harka069/GPS-receiver/README.md

# GPS-receiver (work in progress)
Multi-channel GPS receiver for L1 carrier with dedicated high-frequency frontend, processing within DSP routines and user interface on a personal computer.

## Development tools (start here)
To begin designing our own GPS receiver, we must first create proper tools for designing microcontrollers, FPGA circuits, and programmers. We need to build the following:
- [FPGA programmer](development%20tools/FPGA/FPGA%20programmer)
- [FPGA development board](development%20tools/FPGA/FPGA%20demo%20board)
- [MCU development board](development%20tools/MCU)
