harka069/GPS-receiver/development tools/FPGA/FPGA demo board/iCE40LP384_demo_project/iCE40LP384_blink/iCE40LP384_blink_Implmnt/synlog/report/iCE40LP384_blink_compiler_errors.txt

@E: CS164 :"C:\Users\Aljaz\OneDrive - Univerza v Ljubljani\PROJEKTI\GPS sprejemnik\FPGA\iCE40LP384-SG32\iCE40LP384_demo_project\main.v":28:30:28:33|Expecting wire for output connection, found LED2
