harka069/GPS-receiver/development tools/FPGA/FPGA demo board/iCE40LP384_demo_project/iCE40LP384_blink/iCE40LP384_blink_Implmnt/synlog/report/iCE40LP384_blink_compiler_warnings.txt

@W: CG921 :"C:\Users\Aljaz\OneDrive - Univerza v Ljubljani\PROJEKTI\GPS sprejemnik\FPGA\iCE40LP384-SG32\iCE40LP384_demo_project\main.v":12:5:12:8|LED1 is already declared in this scope.
