harka069/GPS-receiver/development tools/FPGA/FPGA demo board/iCE40LP384_demo_project/iCE40LP384_blink/iCE40LP384_blink_Implmnt/syntmp/statusReport.html

Project Settings
Project Name | iCE40LP384_blink_syn | Implementation Name | iCE40LP384_blink_Implmnt
Top Module | [auto] | Pipelining | 1
Retiming | 0 | Resource Sharing | 1
Fanout Guide | 10000 | Disable I/O Insertion | 0
Disable Sequential Optimizations | 0 | Clock Conversion | 1

Run Status
Job Name | Status | | | | CPU Time | Real Time | Memory | Date/Time
(compiler) | Complete | 6 | 0 | 0 | - | 00m:01s | - | 27/11/2023 20:20:13
(premap) | Complete | 3 | 1 | 0 | 0m:00s | 0m:00s | 133MB | 27/11/2023 20:20:15
(fpga_mapper) | Complete | 10 | 2 | 0 | 0m:00s | 0m:01s | 134MB | 27/11/2023 20:20:16
Multi-srs Generator | Complete | | | | | | | 27/11/2023 20:20:14

Area Summary
PADS | 5 | FLOPS | 25
RAMS (v_ram) | 0 | CARRYS | 24
LUTS (total_luts) | 25

Timing Summary
Clock Name | Req Freq | Est Freq | Slack
main|clk | 129.0 MHz | 109.6 MHz | -1.368

Optimizations Summary
Combined Clock Conversion | 1 / 0
