harka069/GPS-receiver/development tools/MCU/schematic_MCU_board_STM32G441.pdf

1 | 2 | 3 | 4 | 5 | 6 | 7 | 8

A

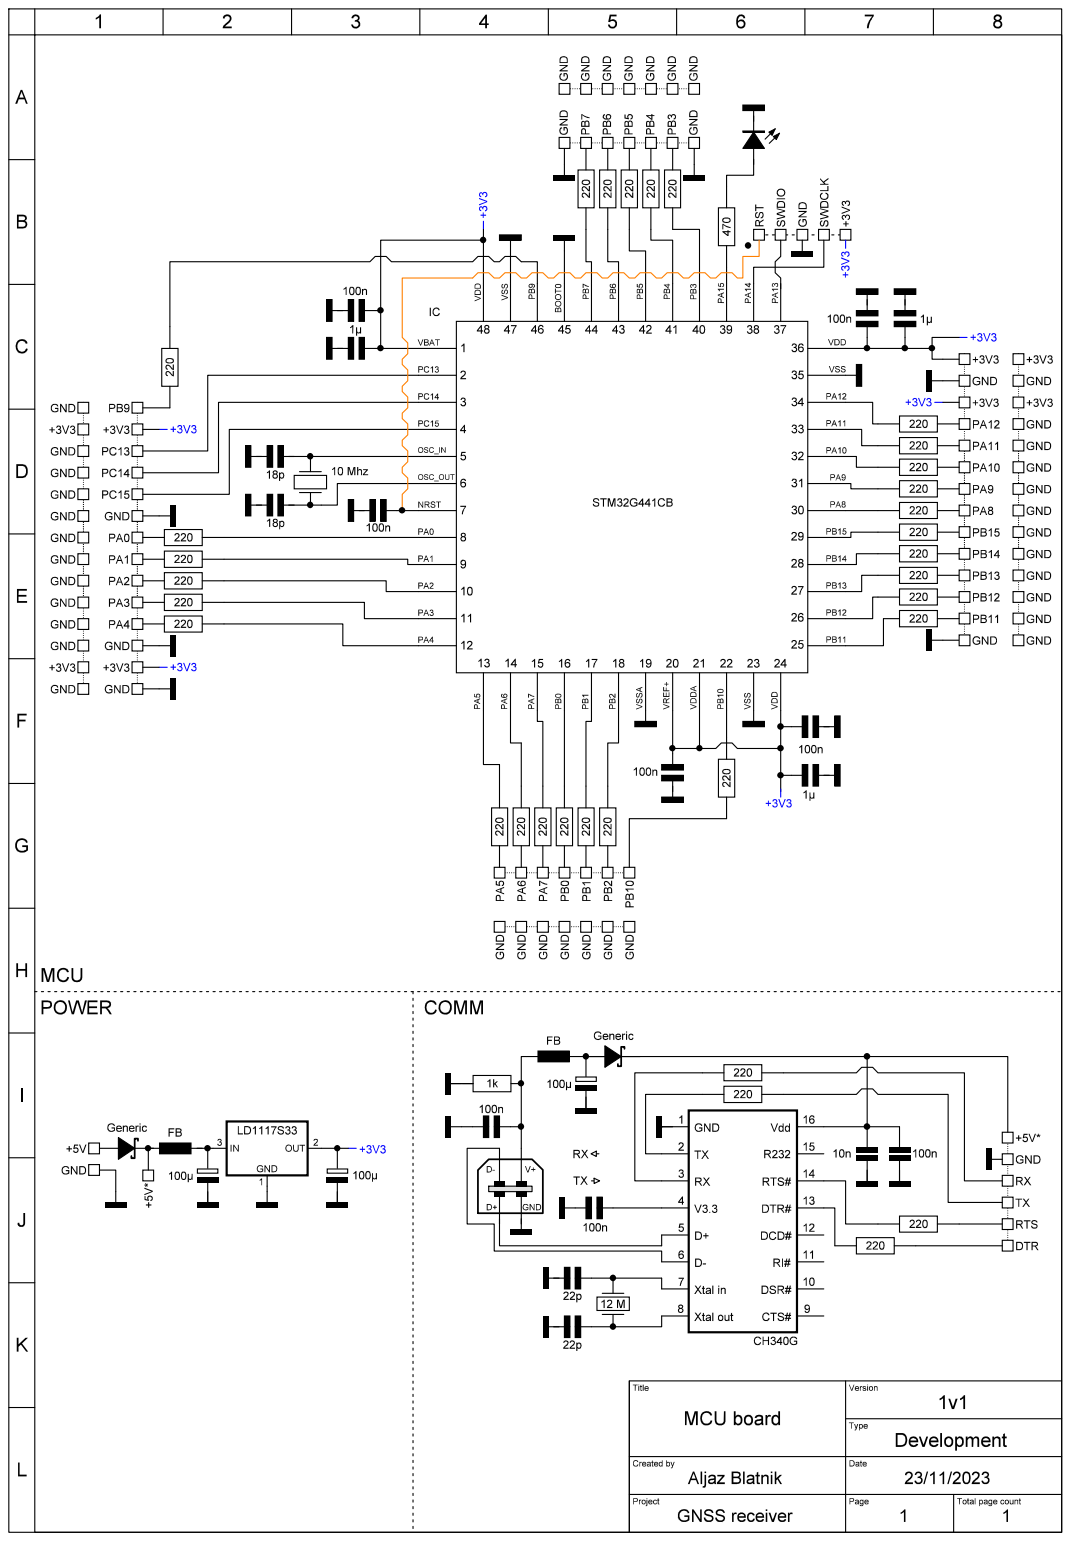
[picture p9: page 1]
