harka069/GPS-receiver/development tools/FPGA/FPGA demo board/schematic_iCE40LP384_demo_board.pdf

1 | 2 | 3 | 4 | 5 | 6 | 7 | 8 | 9 | 10 | 11 | 12

A

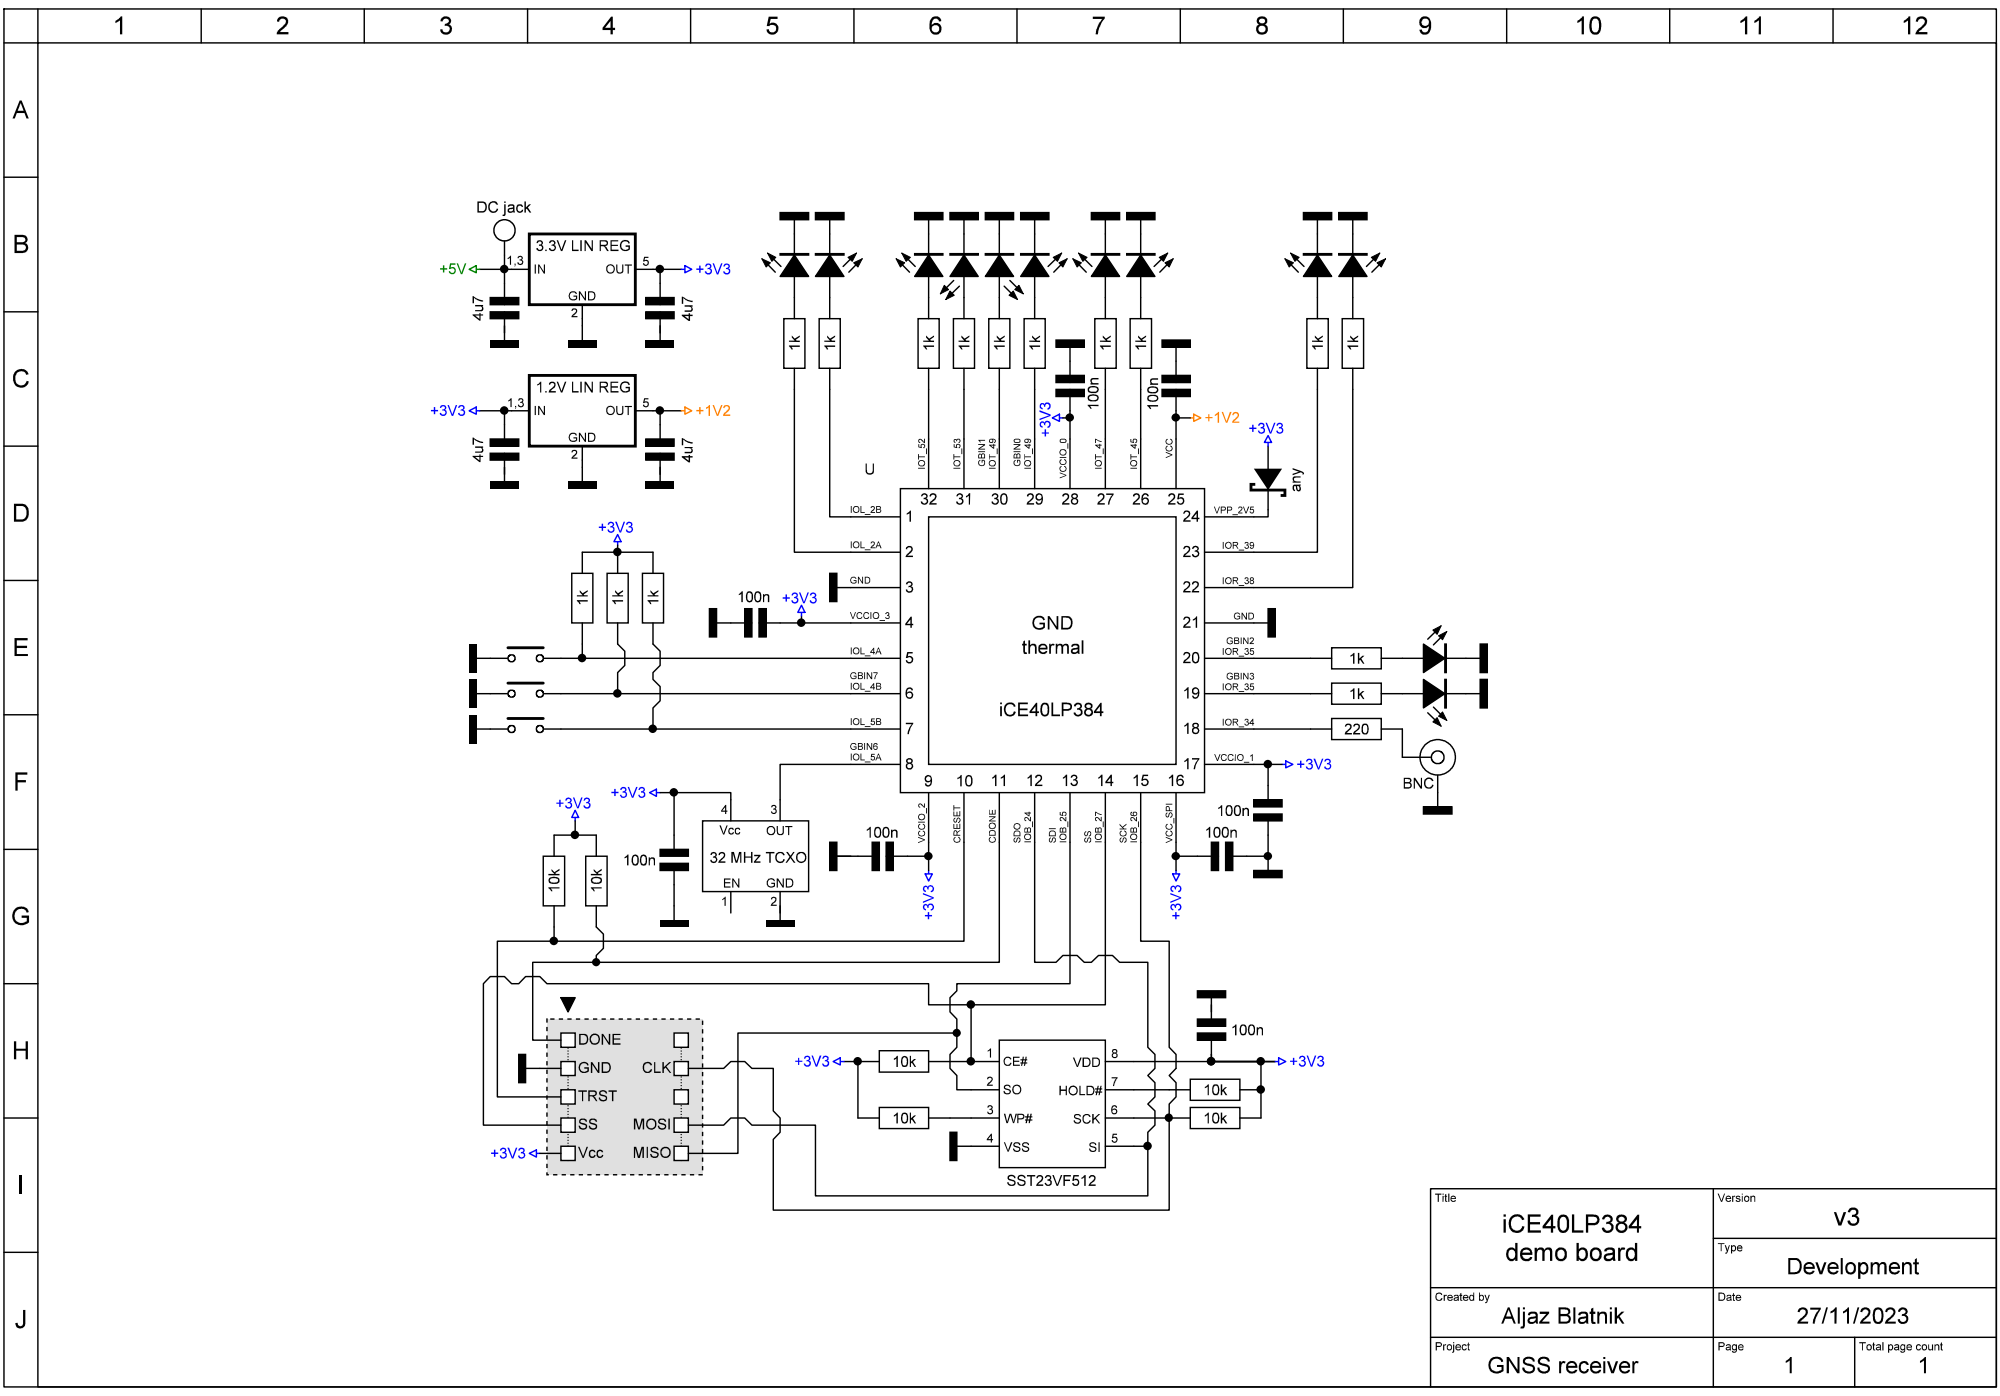
[picture p10: page 1]
