harka069/GPS-receiver/development tools/FPGA/FPGA programmer/schematic_Lattice_LSO_programmer.pdf

1 | 2 | 3 | 4 | 5 | 6 | 7 | 8 | 9 | 10 | 11 | 12

A

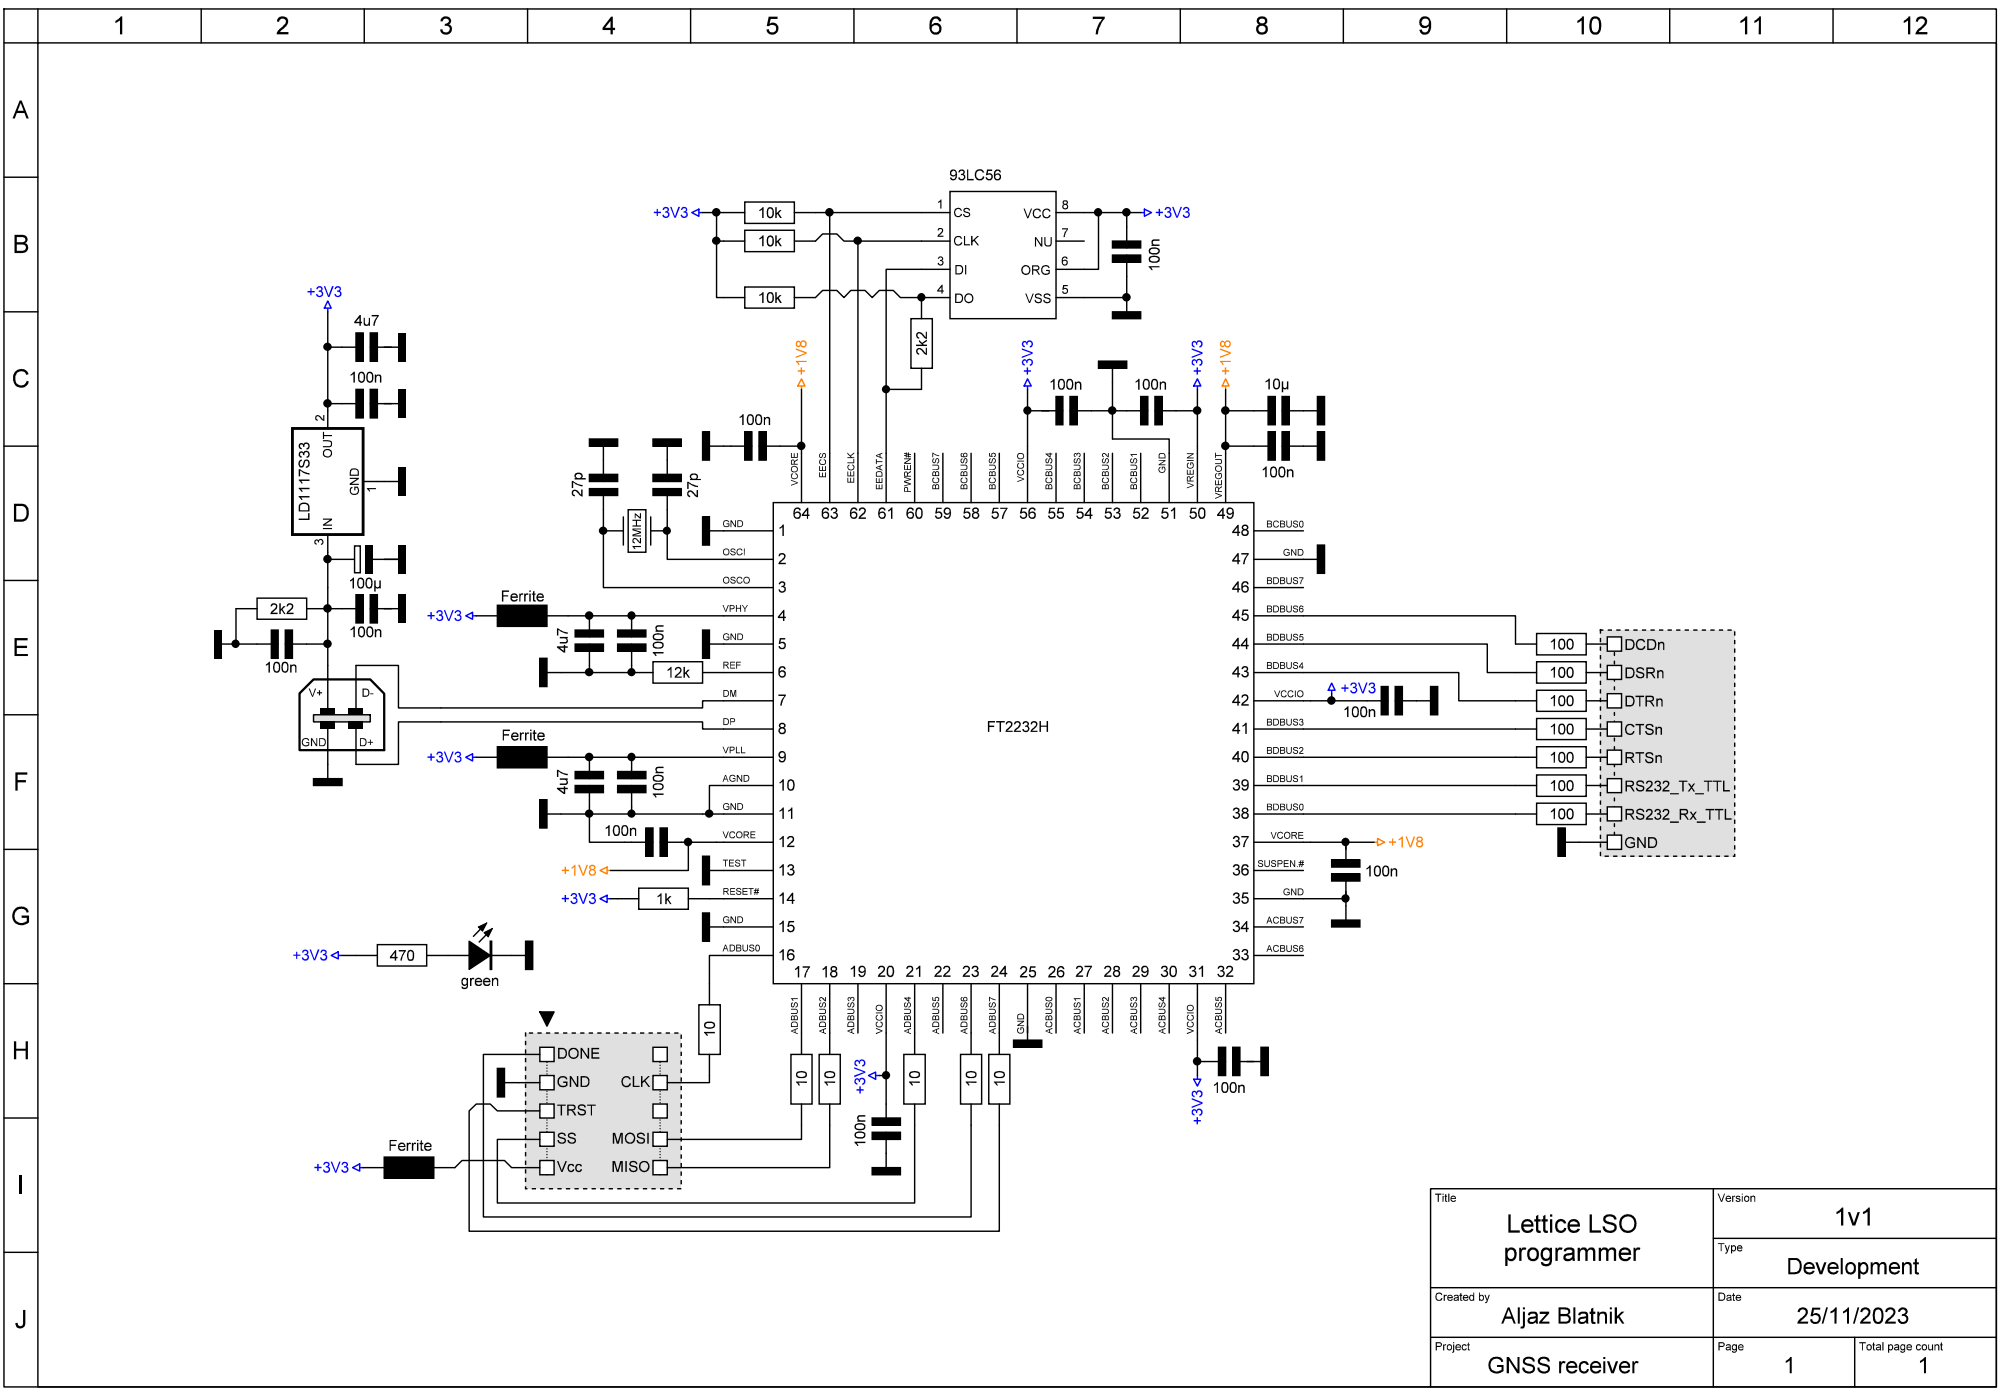
[picture p11: page 1]
