harka069/GPS-receiver/(list of files, drawings)

Other design files:
development tools/FPGA/FPGA demo board/iCE40LP384-SG32_demo_board.lay6
development tools/FPGA/FPGA demo board/iCE40LP384_demo_board.spl8
development tools/FPGA/FPGA programmer/Lattice_LSO_programmer.lay6
development tools/MCU/MCU_board_STM32G441.lay6
development tools/MCU/MCU_board_STM32G441.spl8
