harka069/GPS-receiver/development tools/FPGA/FPGA demo board/iCE40LP384_demo_project/iCE40LP384_blink/iCE40LP384_blink_Implmnt/sbt/outputs/simulation_netlist/main_sbt.v

// ******************************************************************************

// iCEcube Netlister

// Version:            2020.12.27943

// Build Date:         Dec  9 2020 18:18:12

// File Generated:     Nov 27 2023 20:23:32

// Purpose:            Post-Route Verilog/VHDL netlist for timing simulation

// Copyright (C) 2006-2010 by Lattice Semiconductor Corp. All rights reserved.

// ******************************************************************************

// Verilog file for cell "main" view "INTERFACE"

module main (
    LED2,
    BTN1,
    clk,
    LED3,
    LED1);

    output LED2;
    input BTN1;
    input clk;
    output LED3;
    output LED1;

    wire N__804;
    wire N__803;
    wire N__802;
    wire N__793;
    wire N__792;
    wire N__791;
    wire N__784;
    wire N__783;
    wire N__782;
    wire N__775;
    wire N__774;
    wire N__773;
    wire N__766;
    wire N__765;
    wire N__764;
    wire N__747;
    wire N__744;
    wire N__741;
    wire N__738;
    wire N__735;
    wire N__732;
    wire N__729;
    wire N__726;
    wire N__723;
    wire N__720;
    wire N__717;
    wire N__714;
    wire N__711;
    wire N__708;
    wire N__705;
    wire N__702;
    wire N__699;
    wire N__696;
    wire N__693;
    wire N__690;
    wire N__687;
    wire N__684;
    wire N__681;
    wire N__678;
    wire N__675;
    wire N__672;
    wire N__671;
    wire N__668;
    wire N__665;
    wire N__660;
    wire N__659;
    wire N__658;
    wire N__657;
    wire N__648;
    wire N__645;
    wire N__642;
    wire N__639;
    wire N__636;
    wire N__633;
    wire N__630;
    wire N__627;
    wire N__624;
    wire N__621;
    wire N__618;
    wire N__615;
    wire N__612;
    wire N__609;
    wire N__606;
    wire N__603;
    wire N__600;
    wire N__597;
    wire N__594;
    wire N__591;
    wire N__588;
    wire N__585;
    wire N__582;
    wire N__579;
    wire N__576;
    wire N__573;
    wire N__570;
    wire N__567;
    wire N__564;
    wire N__561;
    wire N__558;
    wire N__555;
    wire N__552;
    wire N__549;
    wire N__546;
    wire N__543;
    wire N__540;
    wire N__537;
    wire N__534;
    wire N__531;
    wire N__528;
    wire N__525;
    wire N__522;
    wire N__519;
    wire N__516;
    wire N__513;
    wire N__510;
    wire N__507;
    wire N__504;
    wire N__501;
    wire N__498;
    wire N__495;
    wire N__492;
    wire N__489;
    wire N__486;
    wire N__483;
    wire N__480;
    wire N__477;
    wire N__474;
    wire N__471;
    wire N__468;
    wire N__465;
    wire N__462;
    wire N__459;
    wire N__456;
    wire N__453;
    wire N__450;
    wire N__447;
    wire N__444;
    wire N__441;
    wire N__438;
    wire N__435;
    wire N__432;
    wire N__429;
    wire N__426;
    wire N__423;
    wire N__420;
    wire N__417;
    wire N__414;
    wire VCCG0;
    wire BTN1_c;
    wire GNDG0;
    wire CONSTANT_ONE_NET;
    wire clk_divZ0Z_0;
    wire bfn_2_5_0_;
    wire clk_divZ0Z_1;
    wire clk_div_cry_0;
    wire clk_divZ0Z_2;
    wire clk_div_cry_1;
    wire clk_divZ0Z_3;
    wire clk_div_cry_2;
    wire clk_divZ0Z_4;
    wire clk_div_cry_3;
    wire clk_divZ0Z_5;
    wire clk_div_cry_4;
    wire clk_divZ0Z_6;
    wire clk_div_cry_5;
    wire clk_divZ0Z_7;
    wire clk_div_cry_6;
    wire clk_div_cry_7;
    wire clk_divZ0Z_8;
    wire bfn_2_6_0_;
    wire clk_divZ0Z_9;
    wire clk_div_cry_8;
    wire clk_divZ0Z_10;
    wire clk_div_cry_9;
    wire clk_divZ0Z_11;
    wire clk_div_cry_10;
    wire clk_divZ0Z_12;
    wire clk_div_cry_11;
    wire clk_divZ0Z_13;
    wire clk_div_cry_12;
    wire clk_divZ0Z_14;
    wire clk_div_cry_13;
    wire clk_divZ0Z_15;
    wire clk_div_cry_14;
    wire clk_div_cry_15;
    wire clk_divZ0Z_16;
    wire bfn_2_7_0_;
    wire clk_divZ0Z_17;
    wire clk_div_cry_16;
    wire clk_divZ0Z_18;
    wire clk_div_cry_17;
    wire clk_divZ0Z_19;
    wire clk_div_cry_18;
    wire clk_divZ0Z_20;
    wire clk_div_cry_19;
    wire clk_divZ0Z_21;
    wire clk_div_cry_20;
    wire clk_divZ0Z_22;
    wire clk_div_cry_21;
    wire clk_divZ0Z_23;
    wire clk_div_cry_22;
    wire clk_div_cry_23;
    wire bfn_2_8_0_;
    wire LED3_c;
    wire clk_c_g;
    wire _gnd_net_;

    PRE_IO_GBUF clk_ibuf_gb_io_preiogbuf (
            .PADSIGNALTOGLOBALBUFFER(N__802),
            .GLOBALBUFFEROUTPUT(clk_c_g));
    defparam clk_ibuf_gb_io_iopad.PULLUP=1'b0;
    defparam clk_ibuf_gb_io_iopad.IO_STANDARD="SB_LVCMOS";
    IO_PAD clk_ibuf_gb_io_iopad (
            .OE(N__804),
            .DIN(N__803),
            .DOUT(N__802),
            .PACKAGEPIN(clk));
    defparam clk_ibuf_gb_io_preio.NEG_TRIGGER=1'b0;
    defparam clk_ibuf_gb_io_preio.PIN_TYPE=6'b000001;
    PRE_IO clk_ibuf_gb_io_preio (
            .PADOEN(N__804),
            .PADOUT(N__803),
            .PADIN(N__802),
            .CLOCKENABLE(),
            .DOUT1(),
            .OUTPUTENABLE(),
            .DIN0(),
            .DOUT0(),
            .INPUTCLK(),
            .LATCHINPUTVALUE(),
            .DIN1(),
            .OUTPUTCLK());
    defparam LED2_obuf_iopad.PULLUP=1'b0;
    defparam LED2_obuf_iopad.IO_STANDARD="SB_LVCMOS";
    IO_PAD LED2_obuf_iopad (
            .OE(N__793),
            .DIN(N__792),
            .DOUT(N__791),
            .PACKAGEPIN(LED2));
    defparam LED2_obuf_preio.NEG_TRIGGER=1'b0;
    defparam LED2_obuf_preio.PIN_TYPE=6'b011001;
    PRE_IO LED2_obuf_preio (
            .PADOEN(N__793),
            .PADOUT(N__792),
            .PADIN(N__791),
            .CLOCKENABLE(),
            .DOUT1(),
            .OUTPUTENABLE(),
            .DIN0(),
            .DOUT0(N__438),
            .INPUTCLK(),
            .LATCHINPUTVALUE(),
            .DIN1(),
            .OUTPUTCLK());
    defparam BTN1_ibuf_iopad.PULLUP=1'b0;
    defparam BTN1_ibuf_iopad.IO_STANDARD="SB_LVCMOS";
    IO_PAD BTN1_ibuf_iopad (
            .OE(N__784),
            .DIN(N__783),
            .DOUT(N__782),
            .PACKAGEPIN(BTN1));
    defparam BTN1_ibuf_preio.NEG_TRIGGER=1'b0;
    defparam BTN1_ibuf_preio.PIN_TYPE=6'b000001;
    PRE_IO BTN1_ibuf_preio (
            .PADOEN(N__784),
            .PADOUT(N__783),
            .PADIN(N__782),
            .CLOCKENABLE(),
            .DOUT1(),
            .OUTPUTENABLE(),
            .DIN0(BTN1_c),
            .DOUT0(),
            .INPUTCLK(),
            .LATCHINPUTVALUE(),
            .DIN1(),
            .OUTPUTCLK());
    defparam LED1_obuf_iopad.PULLUP=1'b0;
    defparam LED1_obuf_iopad.IO_STANDARD="SB_LVCMOS";
    IO_PAD LED1_obuf_iopad (
            .OE(N__775),
            .DIN(N__774),
            .DOUT(N__773),
            .PACKAGEPIN(LED1));
    defparam LED1_obuf_preio.NEG_TRIGGER=1'b0;
    defparam LED1_obuf_preio.PIN_TYPE=6'b011001;
    PRE_IO LED1_obuf_preio (
            .PADOEN(N__775),
            .PADOUT(N__774),
            .PADIN(N__773),
            .CLOCKENABLE(),
            .DOUT1(),
            .OUTPUTENABLE(),
            .DIN0(),
            .DOUT0(N__429),
            .INPUTCLK(),
            .LATCHINPUTVALUE(),
            .DIN1(),
            .OUTPUTCLK());
    defparam LED3_obuf_iopad.PULLUP=1'b0;
    defparam LED3_obuf_iopad.IO_STANDARD="SB_LVCMOS";
    IO_PAD LED3_obuf_iopad (
            .OE(N__766),
            .DIN(N__765),
            .DOUT(N__764),
            .PACKAGEPIN(LED3));
    defparam LED3_obuf_preio.NEG_TRIGGER=1'b0;
    defparam LED3_obuf_preio.PIN_TYPE=6'b011001;
    PRE_IO LED3_obuf_preio (
            .PADOEN(N__766),
            .PADOUT(N__765),
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
            .O(N__462),
            .I(N__459));
    InMux I__53 (
            .O(N__459),
            .I(N__456));
    LocalMux I__52 (
            .O(N__456),
            .I(clk_divZ0Z_7));
    InMux I__51 (
            .O(N__453),
            .I(clk_div_cry_6));
    CascadeMux I__50 (
            .O(N__450),
            .I(N__447));
    InMux I__49 (
            .O(N__447),
            .I(N__444));
    LocalMux I__48 (
            .O(N__444),
            .I(clk_divZ0Z_8));
    InMux I__47 (
            .O(N__441),
            .I(bfn_2_6_0_));
    IoInMux I__46 (
            .O(N__438),
            .I(N__435));
    LocalMux I__45 (
            .O(N__435),
            .I(N__432));
    Odrv4 I__44 (
            .O(N__432),
            .I(BTN1_c));
    IoInMux I__43 (
            .O(N__429),
            .I(N__426));
    LocalMux I__42 (
            .O(N__426),
            .I(CONSTANT_ONE_NET));
    CascadeMux I__41 (
            .O(N__423),
            .I(N__420));
    InMux I__40 (
            .O(N__420),
            .I(N__417));
    LocalMux I__39 (
            .O(N__417),
            .I(clk_divZ0Z_0));
    InMux I__38 (
            .O(N__414),
            .I(bfn_2_5_0_));
    defparam IN_MUX_bfv_2_5_0_.C_INIT=2'b01;
    ICE_CARRY_IN_MUX IN_MUX_bfv_2_5_0_ (
            .carryinitin(),
            .carryinitout(bfn_2_5_0_));
    defparam IN_MUX_bfv_2_6_0_.C_INIT=2'b10;
    ICE_CARRY_IN_MUX IN_MUX_bfv_2_6_0_ (
            .carryinitin(clk_div_cry_7),
            .carryinitout(bfn_2_6_0_));
    defparam IN_MUX_bfv_2_7_0_.C_INIT=2'b10;
    ICE_CARRY_IN_MUX IN_MUX_bfv_2_7_0_ (
            .carryinitin(clk_div_cry_15),
            .carryinitout(bfn_2_7_0_));
    defparam IN_MUX_bfv_2_8_0_.C_INIT=2'b10;
    ICE_CARRY_IN_MUX IN_MUX_bfv_2_8_0_ (
            .carryinitin(clk_div_cry_23),
            .carryinitout(bfn_2_8_0_));
    VCC VCC (
            .Y(VCCG0));
    GND GND (
            .Y(GNDG0));
    GND GND_Inst (
            .Y(_gnd_net_));
    defparam CONSTANT_ONE_LUT4_LC_1_7_1.C_ON=1'b0;
    defparam CONSTANT_ONE_LUT4_LC_1_7_1.SEQ_MODE=4'b0000;
    defparam CONSTANT_ONE_LUT4_LC_1_7_1.LUT_INIT=16'b1111111111111111;
    LogicCell40 CONSTANT_ONE_LUT4_LC_1_7_1 (
            .in0(_gnd_net_),
            .in1(_gnd_net_),
            .in2(_gnd_net_),
            .in3(_gnd_net_),
            .lcout(CONSTANT_ONE_NET),
            .ltout(),
            .carryin(_gnd_net_),
            .carryout(),
            .clk(_gnd_net_),
            .ce(),
            .sr(_gnd_net_));
    defparam clk_div_0_LC_2_5_0.C_ON=1'b1;
    defparam clk_div_0_LC_2_5_0.SEQ_MODE=4'b1000;
    defparam clk_div_0_LC_2_5_0.LUT_INIT=16'b1010010101011010;
    LogicCell40 clk_div_0_LC_2_5_0 (
            .in0(_gnd_net_),
            .in1(_gnd_net_),
            .in2(N__423),
            .in3(N__414),
            .lcout(clk_divZ0Z_0),
            .ltout(),
            .carryin(bfn_2_5_0_),
            .carryout(clk_div_cry_0),
            .clk(N__657),
            .ce(),
            .sr(_gnd_net_));
    defparam clk_div_1_LC_2_5_1.C_ON=1'b1;
    defparam clk_div_1_LC_2_5_1.SEQ_MODE=4'b1000;
    defparam clk_div_1_LC_2_5_1.LUT_INIT=16'b1010010101011010;
    LogicCell40 clk_div_1_LC_2_5_1 (
            .in0(_gnd_net_),
            .in1(_gnd_net_),
            .in2(N__534),
            .in3(N__525),
            .lcout(clk_divZ0Z_1),
            .ltout(),
            .carryin(clk_div_cry_0),
            .carryout(clk_div_cry_1),
            .clk(N__657),
            .ce(),
            .sr(_gnd_net_));
    defparam clk_div_2_LC_2_5_2.C_ON=1'b1;
    defparam clk_div_2_LC_2_5_2.SEQ_MODE=4'b1000;
    defparam clk_div_2_LC_2_5_2.LUT_INIT=16'b1010010101011010;
    LogicCell40 clk_div_2_LC_2_5_2 (
            .in0(_gnd_net_),
            .in1(_gnd_net_),
            .in2(N__522),
            .in3(N__513),
            .lcout(clk_divZ0Z_2),
            .ltout(),
            .carryin(clk_div_cry_1),
            .carryout(clk_div_cry_2),
            .clk(N__657),
            .ce(),
            .sr(_gnd_net_));
    defparam clk_div_3_LC_2_5_3.C_ON=1'b1;
    defparam clk_div_3_LC_2_5_3.SEQ_MODE=4'b1000;
    defparam clk_div_3_LC_2_5_3.LUT_INIT=16'b1010010101011010;
    LogicCell40 clk_div_3_LC_2_5_3 (
            .in0(_gnd_net_),
            .in1(_gnd_net_),
            .in2(N__510),
            .in3(N__501),
            .lcout(clk_divZ0Z_3),
            .ltout(),
            .carryin(clk_div_cry_2),
            .carryout(clk_div_cry_3),
            .clk(N__657),
            .ce(),
            .sr(_gnd_net_));
    defparam clk_div_4_LC_2_5_4.C_ON=1'b1;
    defparam clk_div_4_LC_2_5_4.SEQ_MODE=4'b1000;
    defparam clk_div_4_LC_2_5_4.LUT_INIT=16'b1010010101011010;
    LogicCell40 clk_div_4_LC_2_5_4 (
            .in0(_gnd_net_),
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
    LogicCell40 clk_div_24_LC_2_8_0 (
            .in0(_gnd_net_),
            .in1(N__671),
            .in2(_gnd_net_),
            .in3(N__675),
            .lcout(LED3_c),
            .ltout(),
            .carryin(_gnd_net_),
            .carryout(),
            .clk(N__660),
            .ce(),
            .sr(_gnd_net_));
endmodule // main
