harka069/GPS-receiver/development tools/FPGA/FPGA demo board/iCE40LP384_demo_project/iCE40LP384_blink/iCE40LP384_blink_Implmnt/sbt/outputs/simulation_netlist/main_sbt.vhd

-- ******************************************************************************

-- iCEcube Netlister

-- Version:            2020.12.27943

-- Build Date:         Dec  9 2020 18:18:06

-- File Generated:     Nov 27 2023 20:23:32

-- Purpose:            Post-Route Verilog/VHDL netlist for timing simulation

-- Copyright (C) 2006-2010 by Lattice Semiconductor Corp. All rights reserved.

-- ******************************************************************************

-- VHDL file for cell "main" view "INTERFACE"

library ieee;
use ieee.std_logic_1164.all;
use ieee.std_logic_arith.all;
use ieee.std_logic_unsigned.all;

library ice;
use ice.vcomponent_vital.all;

-- Entity of main
entity main is
port (
    LED2 : out std_logic;
    BTN1 : in std_logic;
    clk : in std_logic;
    LED3 : out std_logic;
    LED1 : out std_logic);
end main;

-- Architecture of main
-- View name is \INTERFACE\
architecture \INTERFACE\ of main is

signal \N__804\ : std_logic;
signal \N__803\ : std_logic;
signal \N__802\ : std_logic;
signal \N__793\ : std_logic;
signal \N__792\ : std_logic;
signal \N__791\ : std_logic;
signal \N__784\ : std_logic;
signal \N__783\ : std_logic;
signal \N__782\ : std_logic;
signal \N__775\ : std_logic;
signal \N__774\ : std_logic;
signal \N__773\ : std_logic;
signal \N__766\ : std_logic;
signal \N__765\ : std_logic;
signal \N__764\ : std_logic;
signal \N__747\ : std_logic;
signal \N__744\ : std_logic;
signal \N__741\ : std_logic;
signal \N__738\ : std_logic;
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
signal clk_div_cry_12 : std_logic;
signal \clk_divZ0Z_14\ : std_logic;
signal clk_div_cry_13 : std_logic;
signal \clk_divZ0Z_15\ : std_logic;
signal clk_div_cry_14 : std_logic;
signal clk_div_cry_15 : std_logic;
signal \clk_divZ0Z_16\ : std_logic;
signal \bfn_2_7_0_\ : std_logic;
signal \clk_divZ0Z_17\ : std_logic;
signal clk_div_cry_16 : std_logic;
signal \clk_divZ0Z_18\ : std_logic;
signal clk_div_cry_17 : std_logic;
signal \clk_divZ0Z_19\ : std_logic;
signal clk_div_cry_18 : std_logic;
signal \clk_divZ0Z_20\ : std_logic;
signal clk_div_cry_19 : std_logic;
signal \clk_divZ0Z_21\ : std_logic;
signal clk_div_cry_20 : std_logic;
signal \clk_divZ0Z_22\ : std_logic;
signal clk_div_cry_21 : std_logic;
signal \clk_divZ0Z_23\ : std_logic;
signal clk_div_cry_22 : std_logic;
signal clk_div_cry_23 : std_logic;
signal \bfn_2_8_0_\ : std_logic;
signal \LED3_c\ : std_logic;
signal clk_c_g : std_logic;
signal \_gnd_net_\ : std_logic;

signal clk_wire : std_logic;
signal \LED2_wire\ : std_logic;
signal \BTN1_wire\ : std_logic;
signal \LED1_wire\ : std_logic;
signal \LED3_wire\ : std_logic;

begin
    clk_wire <= clk;
    LED2 <= \LED2_wire\;
    \BTN1_wire\ <= BTN1;
    LED1 <= \LED1_wire\;
    LED3 <= \LED3_wire\;

    \clk_ibuf_gb_io_preiogbuf\ : PRE_IO_GBUF
    port map (
            PADSIGNALTOGLOBALBUFFER => \N__802\,
            GLOBALBUFFEROUTPUT => clk_c_g
        );

    \clk_ibuf_gb_io_iopad\ : IO_PAD
    generic map (
            PULLUP => '0',
            IO_STANDARD => "SB_LVCMOS"
        )
    port map (
            OE => \N__804\,
            DIN => \N__803\,
            DOUT => \N__802\,
            PACKAGEPIN => clk_wire
        );

    \clk_ibuf_gb_io_preio\ : PRE_IO
    generic map (
            NEG_TRIGGER => '0',
            PIN_TYPE => "000001"
        )
    port map (
            PADOEN => \N__804\,
            PADOUT => \N__803\,
            PADIN => \N__802\,
            CLOCKENABLE => 'H',
            DOUT1 => '0',
            OUTPUTENABLE => '0',
            DIN0 => OPEN,
            DOUT0 => '0',
            INPUTCLK => '0',
            LATCHINPUTVALUE => '0',
            DIN1 => OPEN,
            OUTPUTCLK => '0'
        );

    \LED2_obuf_iopad\ : IO_PAD
    generic map (
            PULLUP => '0',
            IO_STANDARD => "SB_LVCMOS"
        )
    port map (
            OE => \N__793\,
            DIN => \N__792\,
            DOUT => \N__791\,
            PACKAGEPIN => \LED2_wire\
        );

    \LED2_obuf_preio\ : PRE_IO
    generic map (
            NEG_TRIGGER => '0',
            PIN_TYPE => "011001"
        )
    port map (
            PADOEN => \N__793\,
            PADOUT => \N__792\,
            PADIN => \N__791\,
            CLOCKENABLE => 'H',
            DOUT1 => '0',
            OUTPUTENABLE => '0',
            DIN0 => OPEN,
            DOUT0 => \N__438\,
            INPUTCLK => '0',
            LATCHINPUTVALUE => '0',
            DIN1 => OPEN,
            OUTPUTCLK => '0'
        );

    \BTN1_ibuf_iopad\ : IO_PAD
    generic map (
            PULLUP => '0',
            IO_STANDARD => "SB_LVCMOS"
        )
    port map (
            OE => \N__784\,
            DIN => \N__783\,
            DOUT => \N__782\,
            PACKAGEPIN => \BTN1_wire\
        );

    \BTN1_ibuf_preio\ : PRE_IO
    generic map (
            NEG_TRIGGER => '0',
            PIN_TYPE => "000001"
        )
    port map (
            PADOEN => \N__784\,
            PADOUT => \N__783\,
            PADIN => \N__782\,
            CLOCKENABLE => 'H',
            DOUT1 => '0',
            OUTPUTENABLE => '0',
            DIN0 => \BTN1_c\,
            DOUT0 => '0',
            INPUTCLK => '0',
            LATCHINPUTVALUE => '0',
            DIN1 => OPEN,
            OUTPUTCLK => '0'
        );

    \LED1_obuf_iopad\ : IO_PAD
    generic map (
            PULLUP => '0',
            IO_STANDARD => "SB_LVCMOS"
        )
    port map (
            OE => \N__775\,
            DIN => \N__774\,
            DOUT => \N__773\,
            PACKAGEPIN => \LED1_wire\
        );

    \LED1_obuf_preio\ : PRE_IO
    generic map (
            NEG_TRIGGER => '0',
            PIN_TYPE => "011001"
        )
    port map (
            PADOEN => \N__775\,
            PADOUT => \N__774\,
            PADIN => \N__773\,
            CLOCKENABLE => 'H',
            DOUT1 => '0',
            OUTPUTENABLE => '0',
            DIN0 => OPEN,
            DOUT0 => \N__429\,
            INPUTCLK => '0',
            LATCHINPUTVALUE => '0',
            DIN1 => OPEN,
            OUTPUTCLK => '0'
        );

    \LED3_obuf_iopad\ : IO_PAD
    generic map (
            PULLUP => '0',
            IO_STANDARD => "SB_LVCMOS"
        )
    port map (
            OE => \N__766\,
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
            in2 => \N__687\,
            in3 => \N__678\,
            lcout => \clk_divZ0Z_23\,
            ltout => OPEN,
            carryin => clk_div_cry_22,
            carryout => clk_div_cry_23,
            clk => \N__659\,
            ce => 'H',
            sr => \_gnd_net_\
        );

    \clk_div_24_LC_2_8_0\ : LogicCell40
    generic map (
            C_ON => '0',
            SEQ_MODE => "1000",
            LUT_INIT => "0011001111001100"
        )
    port map (
            in0 => \_gnd_net_\,
            in1 => \N__671\,
            in2 => \_gnd_net_\,
            in3 => \N__675\,
            lcout => \LED3_c\,
            ltout => OPEN,
            carryin => \_gnd_net_\,
            carryout => OPEN,
            clk => \N__660\,
            ce => 'H',
            sr => \_gnd_net_\
        );
end \INTERFACE\;
