harka069/GPS-receiver/(commit log)

2023-11-19 Initial_upload
    Laboratory practicum starting point
    [Lattice_LSO_programmer.lay6, MCU_board.lay6, iCE40LP384-SG32_demo_board.lay6, iCE40LP384_demo_board.spl8, main_pin_table.CSV, main_sbt.sdf, main_sbt_vital.sdf]
2023-11-22 MCU PCB + sch update
    v1.1 of MCU board
    [Backup_of_iCE40LP384_demo_board.spl8, MCU_board.lay6, MCU_board_STM32G441.lay6, MCU_board_STM32G441.spl8]
2023-11-23 MCU example code
    Final v1.1 MCU commit
    [MCU_board_STM32G441.lay6, MCU_board_STM32G441.spl8]
2023-11-25 Lattice programmer
    Added Lattice LSO programmer files
    [Lattice_LSO_programmer.lay6, schematic_Lattice_LSO_programmer.spl8]
2023-11-27 FPGA demo board v3
    Files upload
    [Backup_of_iCE40LP384_demo_board.spl8, Backup_of_schematic_Lattice_LSO_programmer.spl8, iCE40LP384-SG32_demo_board.lay6, iCE40LP384_demo_board.spl8, main_pin_table.CSV, main_sbt.sdf, main_sbt_vital.sdf]
2023-12-08 Readme update
    [Backup_of_iCE40LP384_demo_board.spl8, Backup_of_schematic_Lattice_LSO_programmer.spl8]
